ylj2000/DAP_HS_WL/README.md

# DAP_HS_WL

本项目不支持任何形式的私自产品化，允许个人DIY使用。
