ylj2000/DAP_HS_WL/Fireware/Ver_01/readme.txt

<初版发布固件>
可能存在各种bug，如遇到可以直接联系作者或者Issues下留言
无线调试器使用DAP.7z中的固件
如果只想使用有线功能，不焊接无线模块，使用DAP_None_WL.7z中的固件
