ylj2000/DAP_HS_WL/Hardware/DAP_Main.xlsx

Comment | Description | Designator | Footprint | Quantity
10u | 电容 | C1, C4, C5, C12 | 0603_CAP | 4 | https://item.taobao.com/item.htm?spm=a1z09.2.0.0.16d92e8dSdB7cN&id=537669338432&_u=93msfb8176a1
12pF | 电容 | C2, C6 | 0402_CAP | 2 | https://item.taobao.com/item.htm?spm=a1z09.2.0.0.16d92e8dSdB7cN&id=634060414271&_u=93msfb81a9fc
0.1u | 电容 | C3, C7, C8, C9, C10, C11 | 0402_CAP | 6 | https://item.taobao.com/item.htm?spm=a1z09.2.0.0.16d92e8dSdB7cN&id=523808399191&_u=93msfb815e3d
LED-0603 | 贴片LED | LED1 | LED0603_RED | 1 | https://item.taobao.com/item.htm?spm=a1z10.3-c-s.w4002-21223910208.18.32c66a4bLKf1C5&id=522573257623
RGB-3528 | RGB | LED2, LED3, LED4, LED5 | LED-ARRAY-SMD_3528-4P-L3.5-W2.8-TL-RD | 4 | https://item.taobao.com/item.htm?spm=a1z10.3-c-s.w4002-21223910208.30.61cc6a4bN0yNOE&id=544589431307
Header 4 | 调试口，不焊 | P1 | PAD_2.54_1X4 | 1
Header 6X2 | 排针 | P2 | PAD_2.54_2x6 | 1 | https://item.taobao.com/item.htm?spm=a1z10.3-c-s.w4002-21223910208.16.40c96a4bFvsGUQ&id=540755607552
0.5A | 自恢复保险丝 | R1 | 0603_RES | 1 | https://item.taobao.com/item.htm?spm=a1z09.2.0.0.16d92e8dSdB7cN&id=560313507871&_u=93msfb81c5fa
10K | 电阻 | R2, R4, R6 | 0402_RES | 3 | https://item.taobao.com/item.htm?spm=a1z09.2.0.0.16d92e8dSdB7cN&id=525633713781&_u=93msfb813d5a
5.1K | 电阻 | R3, R5 | 0402_RES | 2 | https://item.taobao.com/item.htm?spm=a1z09.2.0.0.16d92e8dSdB7cN&id=525568819310&_u=93msfb81a6b2
0R | 电阻 | R7, R9 | 0402_RES | 2 | https://item.taobao.com/item.htm?spm=a1z09.2.0.0.16d92e8dSdB7cN&id=605411575000&_u=93msfb813b7c
1.5K | 电阻 | R8 | 0402_RES | 1 | https://item.taobao.com/item.htm?spm=a1z09.2.0.0.16d92e8dSdB7cN&id=525603350689&_u=93msfb8147f8
NC | 不焊 | R10 | 0402_RES | 1
100R | 电阻 | R11, R12, R13, R14, R15, R16, R17 | 0402_RES | 7 | https://item.taobao.com/item.htm?spm=a1z09.2.0.0.16d92e8dSdB7cN&id=525601033663&_u=93msfb81fba0
60.4R | 电阻 | R18 | 0603_RES | 1 | https://item.taobao.com/item.htm?spm=a1z09.2.0.0.16d92e8dSdB7cN&id=525740953644&_u=93msfb81b1d8
130R | 电阻 | R19, R20 | 0603_RES | 2 | https://item.taobao.com/item.htm?spm=a1z09.2.0.0.16d92e8dSdB7cN&id=525740877810&_u=93msfb811852
PTCLG-V-T/R | 轻触开关 | SW1, SW2 | SW-SMD_4P-L4.7-W3.5-P1.70-LS5.9 | 2 | https://item.taobao.com/item.htm?spm=a1z09.2.0.0.16d92e8dSdB7cN&id=546747577238&_u=93msfb81d08b
AMS1117-3.3 | LDO | U1 | SOT-89-3_L4.5-W2.5-P1.50-LS4.2-BR | 1 | https://item.taobao.com/item.htm?spm=a1z10.3-c-s.w4002-21223910208.11.52066a4bp7bBEk&id=654006161406
CH32V307RCT6 | MCU | U2 | CH32V307RCRT6 | 1 | https://item.taobao.com/item.htm?spm=a1z09.2.0.0.16d92e8dSdB7cN&id=665394144915&_u=93msfb816f15
VG2392S240X0M2 | 无线模块 | U3 | WIRELM-SMD_16P-L24.0-W16.0-P2.00_VG2392S240X0M2 | 1 | https://item.taobao.com/item.htm?spm=a1z09.2.0.0.16d92e8dSdB7cN&id=671050877835&_u=93msfb812f3c
TYPE-C-31-M-13 | TYPE-C沉板1.6 | USB1 | USB-C-SMD_TYPE-C-31-M-13 | 1 | https://item.taobao.com/item.htm?spm=a1z09.2.0.0.52da2e8dyd6zCr&id=591365246153&_u=93msfb812eae
12Mhz | 晶振 | X1 | XTAL3225 | 1 | https://item.taobao.com/item.htm?spm=a1z10.3-c-s.w4002-21223910208.12.608e6a4bpUmmAO&id=522572354913
