ylj2000/DAP_HS_WL/(list of files, drawings)

Other design files:
Hardware/DAP_Main.SchDoc
