ylj2000/DAP_HS_WL/(threads)

Thread 1 (2023-01-10):

模块替换

Pursue2, 2023-01-10:
博主能不能使用VG6244S580N0M1这个模块替换一下，这个空中速率更高，且成本更低，VG2392S240X0M2成本太高了

ylj2000, 2023-01-21:
当时考虑过那个模块，但A5133这个芯片，国内做的太少了，芯片都不太买得到，如果想替换比较难；然后包长也只有64字节，现在这个速度下，空中速率其实不是限制速度的最大因素，收发之间的切换时间这种更影响，A5133没有做过测试效果怎样。

Pursue2, 2023-01-21:
哦哦，我没了解过A5133这个芯片，不知道包长只有64KB，因为我最近使用这个模块的时候发现串口的速率很难提升上去，加上成本比较贵，所以想有没有成本低，速度快的模块可以替换一下，不知道博主能否开源一下你的DAPLink源码，我比较想学习一下这个DAPLink的协议
