ylj2000/DAP_HS_WL/(commit log)

2022-08-25 update hw
    [DAP_Main.SchDoc]
2022-10-20 add none wireless fireware
